zolotvok/Rp-2350-cam-module/hardware/proto1/fabrication/bom.csv

Reference | Qty | Value | DNP | Exclude from BOM | Exclude from Board | Footprint | Datasheet | LCSC
C26,C27 | 2 | 20p |  |  |  | Capacitor_SMD:C_0603_1608Metric |  | C1648
C5,C6,C8,C14,C17,C21,C22,C23,C24,C25,C33 | 11 | 0.1uF |  |  |  | Capacitor_SMD:C_0603_1608Metric |  | C14663
C2,C7,C9,C11,C12,C13,C16 | 7 | 1uF |  |  |  | Capacitor_SMD:C_0603_1608Metric |  | C15849
C1,C4 | 2 | 2.2uF |  |  |  | Capacitor_SMD:C_0603_1608Metric |  | C23630
C3 | 1 | 10uF |  |  |  | Capacitor_SMD:C_0805_2012Metric |  | C440198
C34,C35 | 2 | 10u |  |  |  | Capacitor_SMD:C_0805_2012Metric |  | C440198
R5 | 1 | 10 |  |  |  | Resistor_SMD:R_0805_2012Metric |  | C17415
R7,R8 | 2 | 22 ohm |  |  |  | Resistor_SMD:R_0805_2012Metric |  | C17561
R4 | 1 | 200 |  |  |  | Resistor_SMD:R_0805_2012Metric |  | C17540
R23,R26 | 2 | 1K |  |  |  | Resistor_SMD:R_0805_2012Metric |  | C17513
R10,R11,R12,R13,R14 | 5 | 2.2K |  |  |  | Resistor_SMD:R_0805_2012Metric |  | C17520
R1 | 1 | 5k1 |  |  |  | Resistor_SMD:R_0805_2012Metric |  | C27834
R3 | 1 | 5k1 |  |  |  | Resistor_SMD:R_0805_2012Metric_Pad1.20x1.40mm_HandSolder |  | C27834
R2,R6,R9,R16,R21 | 5 | 10K |  |  |  | Resistor_SMD:R_0805_2012Metric |  | C17414
C10 | 1 | 10uF_0805 |  |  |  | Capacitor_SMD:C_0805_2012Metric |  | C440198
C15 | 1 | 10uF_0805 |  |  |  | Capacitor_SMD:C_0603_1608Metric |  | C440198
Y1 | 1 | 12MHz_10pF_50ohm |  |  |  | Crystal:Crystal_SMD_3225-4Pin_3.2x2.5mm |  | C9002
D3 | 1 | 1N4148 |  |  |  | Diode_SMD:D_SOD-123 |  | C81598
U4 | 1 | 74LVC1G19 |  |  |  | Package_TO_SOT_SMD:SOT-23-6_Handsoldering | http://www.ti.com/lit/sg/scyt129e/scyt129e.pdf | C148208
U1,U7 | 2 | APS1604M-3SQRx-SN |  |  |  | Package_SO:SOIC-8_3.9x4.9mm_P1.27mm | https://www.mouser.com/datasheet/2/1127/APM_PSRAM_QSPI_APS1604M_3SQR_v2_7_PKG-1954896.pdf | C18214056
L5 | 1 | BLUE |  |  |  | LED_SMD:LED_0603_1608Metric |  | C2297
J3 | 1 | Conn_01x05_Pin | DNP |  |  | Connector_PinHeader_2.54mm:PinHeader_1x05_P2.54mm_Vertical |  | C22438173
J2 | 1 | Conn_02x09_Counter_Clockwise | DNP |  |  | Connector_IDC:IDC-Header_2x09_P2.54mm_Vertical |  | C22438186
L1 | 1 | DFE252012F-3R3M=P2 |  |  |  | Inductor_SMD:L_1210_3225Metric |  | C2046640
L3,ON0 | 2 | EMERALD GREEN |  |  |  | LED_SMD:LED_0603_1608Metric |  | C2297
DEBUG0 | 1 | JST_SH3 | DNP |  |  | Connector_PinHeader_2.54mm:PinHeader_1x03_P2.54mm_Vertical
U5 | 1 | NCP1117-3.3_SOT223 |  |  |  | Package_TO_SOT_SMD:SOT-223-3_TabPin2 | http://www.onsemi.com/pub_link/Collateral/NCP1117-D.PDF | C6186
L0,L2 | 2 | RED |  |  |  | LED_SMD:LED_0603_1608Metric |  | C84256
X4 | 1 | RP2350B |  |  |  | Package_DFN_QFN:QFN-80-1EP_10x10mm_P0.4mm_EP3.4x3.4mm |  | C42415655
TP1 | 1 | TESTPOINTROUND1.5MMNO | DNP |  |  | TestPoint:TestPoint_Pad_D1.0mm
S1,S2 | 2 | TS-1088-AR02016 |  |  |  | lib_foot:SW_TS-1088-AR02016
J1 | 1 | USB_C_Receptacle_USB2.0_14P |  |  |  | Connector_USB:USB_C_Receptacle_XKB_U262-16XN-4BVC11 | https://www.usb.org/sites/default/files/documents/usb_type-c.zip | C2765186
U2 | 1 | W25Q128JVS |  |  |  | Package_SO:SOIC-8_5.3x5.3mm_P1.27mm | https://www.winbond.com/resource-files/w25q128jv_dtr%20revc%2003272018%20plus.pdf | C97521
L4 | 1 | YELLOW |  |  |  | LED_SMD:LED_0603_1608Metric |  | C34499
