zolotvok/Rp-2350-cam-module/hardware/proto2/docs/schematic.pdf

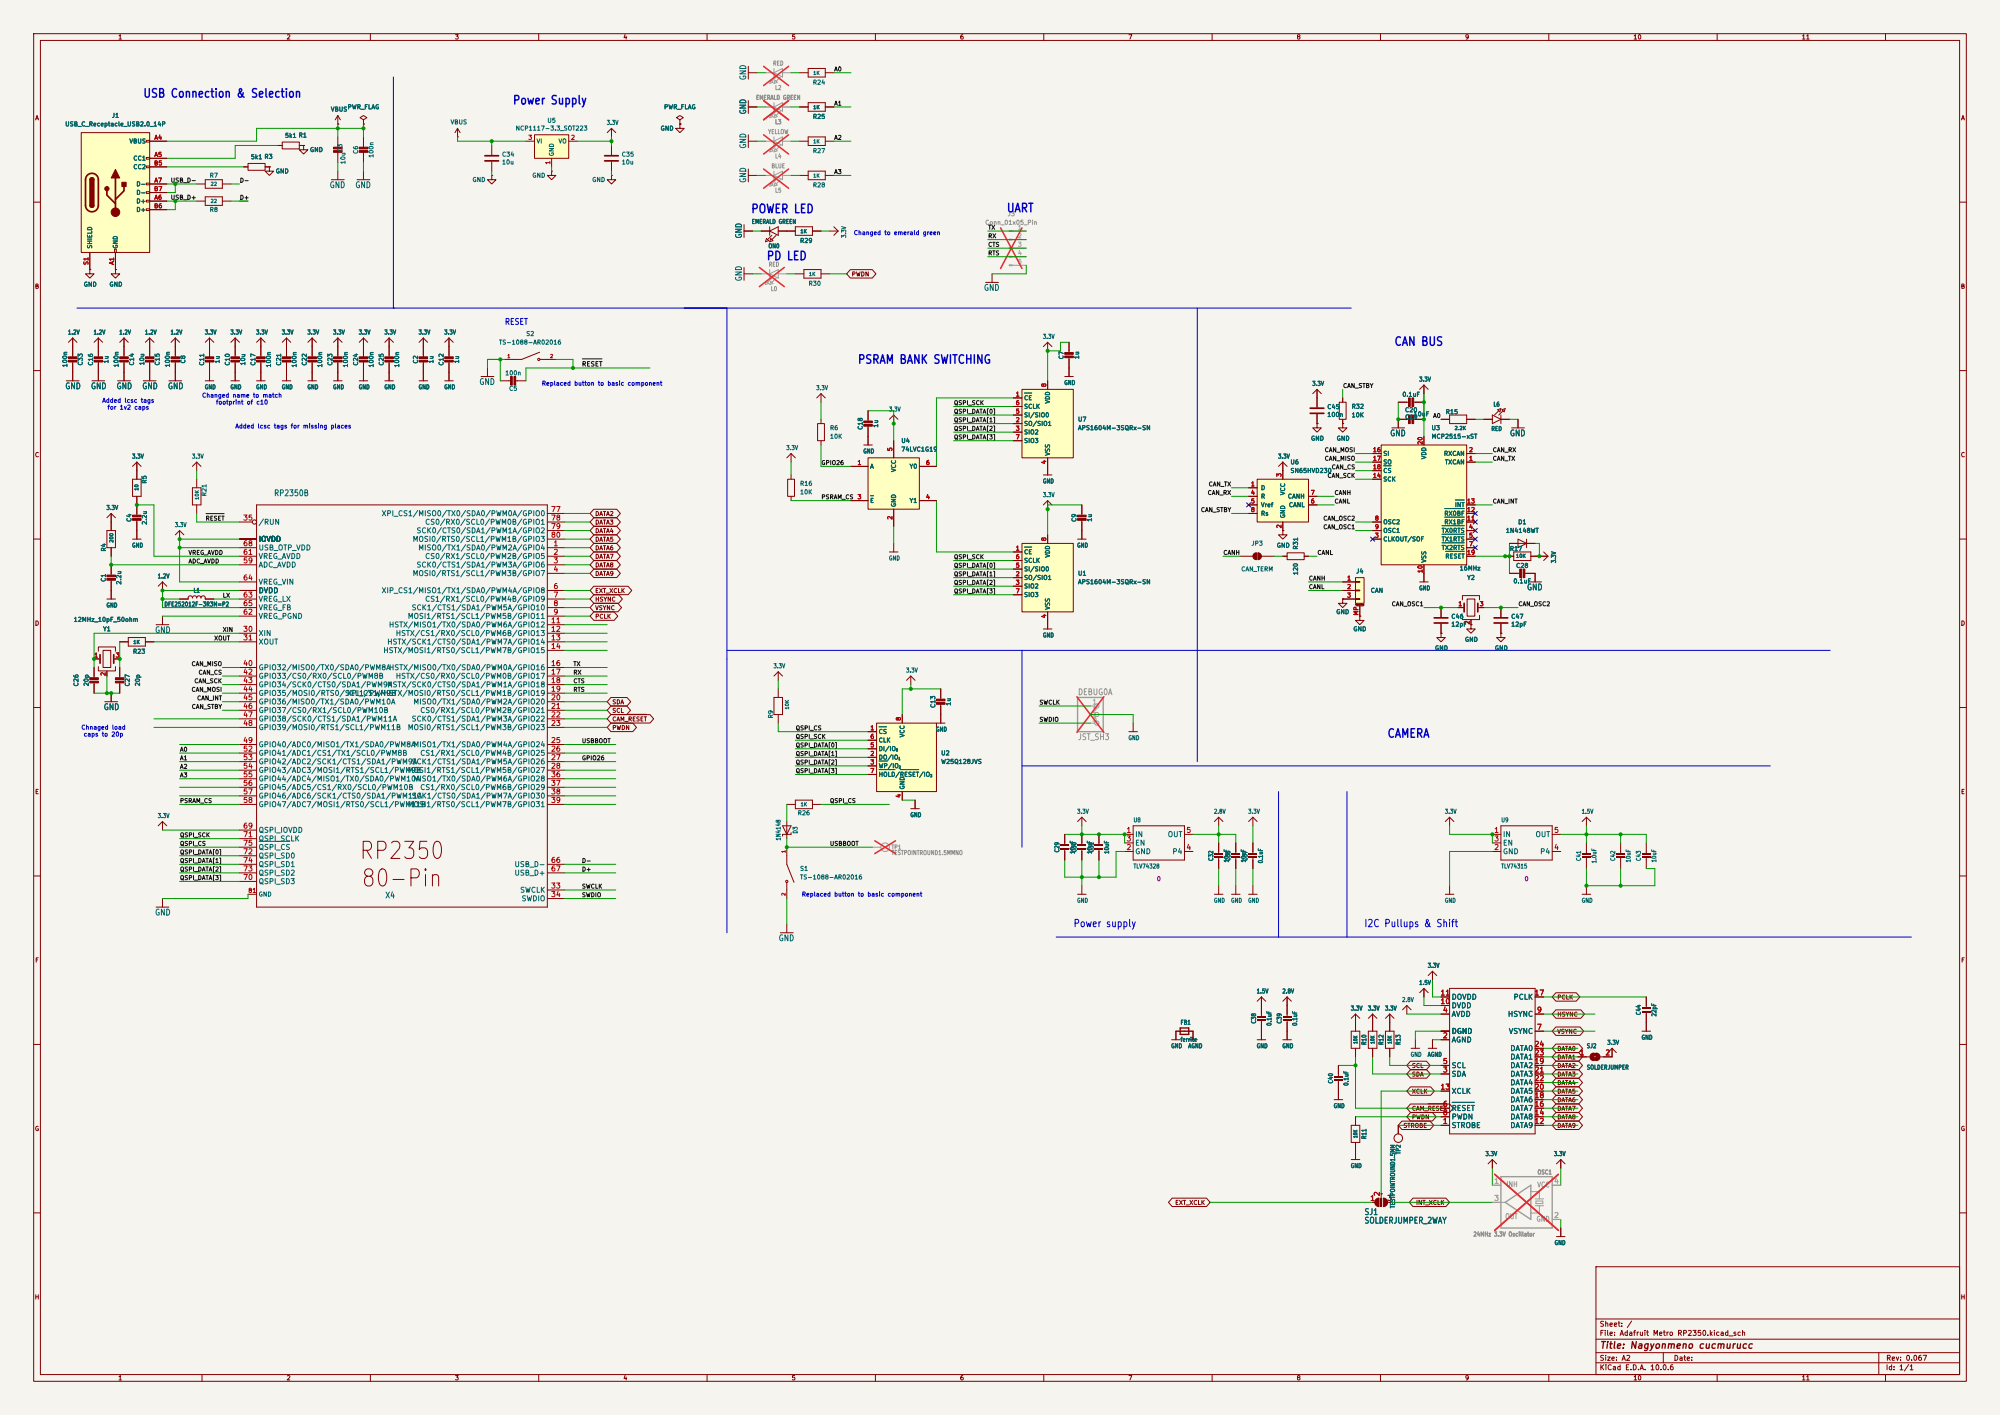
[picture p5: page 1]

Changed to emerald green PSRAM BANK SWITCHING GND

for 1v2 caps Chnaged load

Replaced button to basic component

Changed name to match

Added lcsc tags for missing places

4 DI/IO0 5 CLK 6 HOLD/RESET/IO3 7 VCC

Size: A2 | Rev: 0.067
KiCad E.D.A. 10.0.6 | Id: 1/1
