zolotvok/Rp-2350-cam-module/hardware/proto2/kicad/Adafruit Metro RP2350.kicad_pcb

## KiCad design hardware/proto2/kicad/Adafruit Metro RP2350.kicad_pcb (2026-10-27)

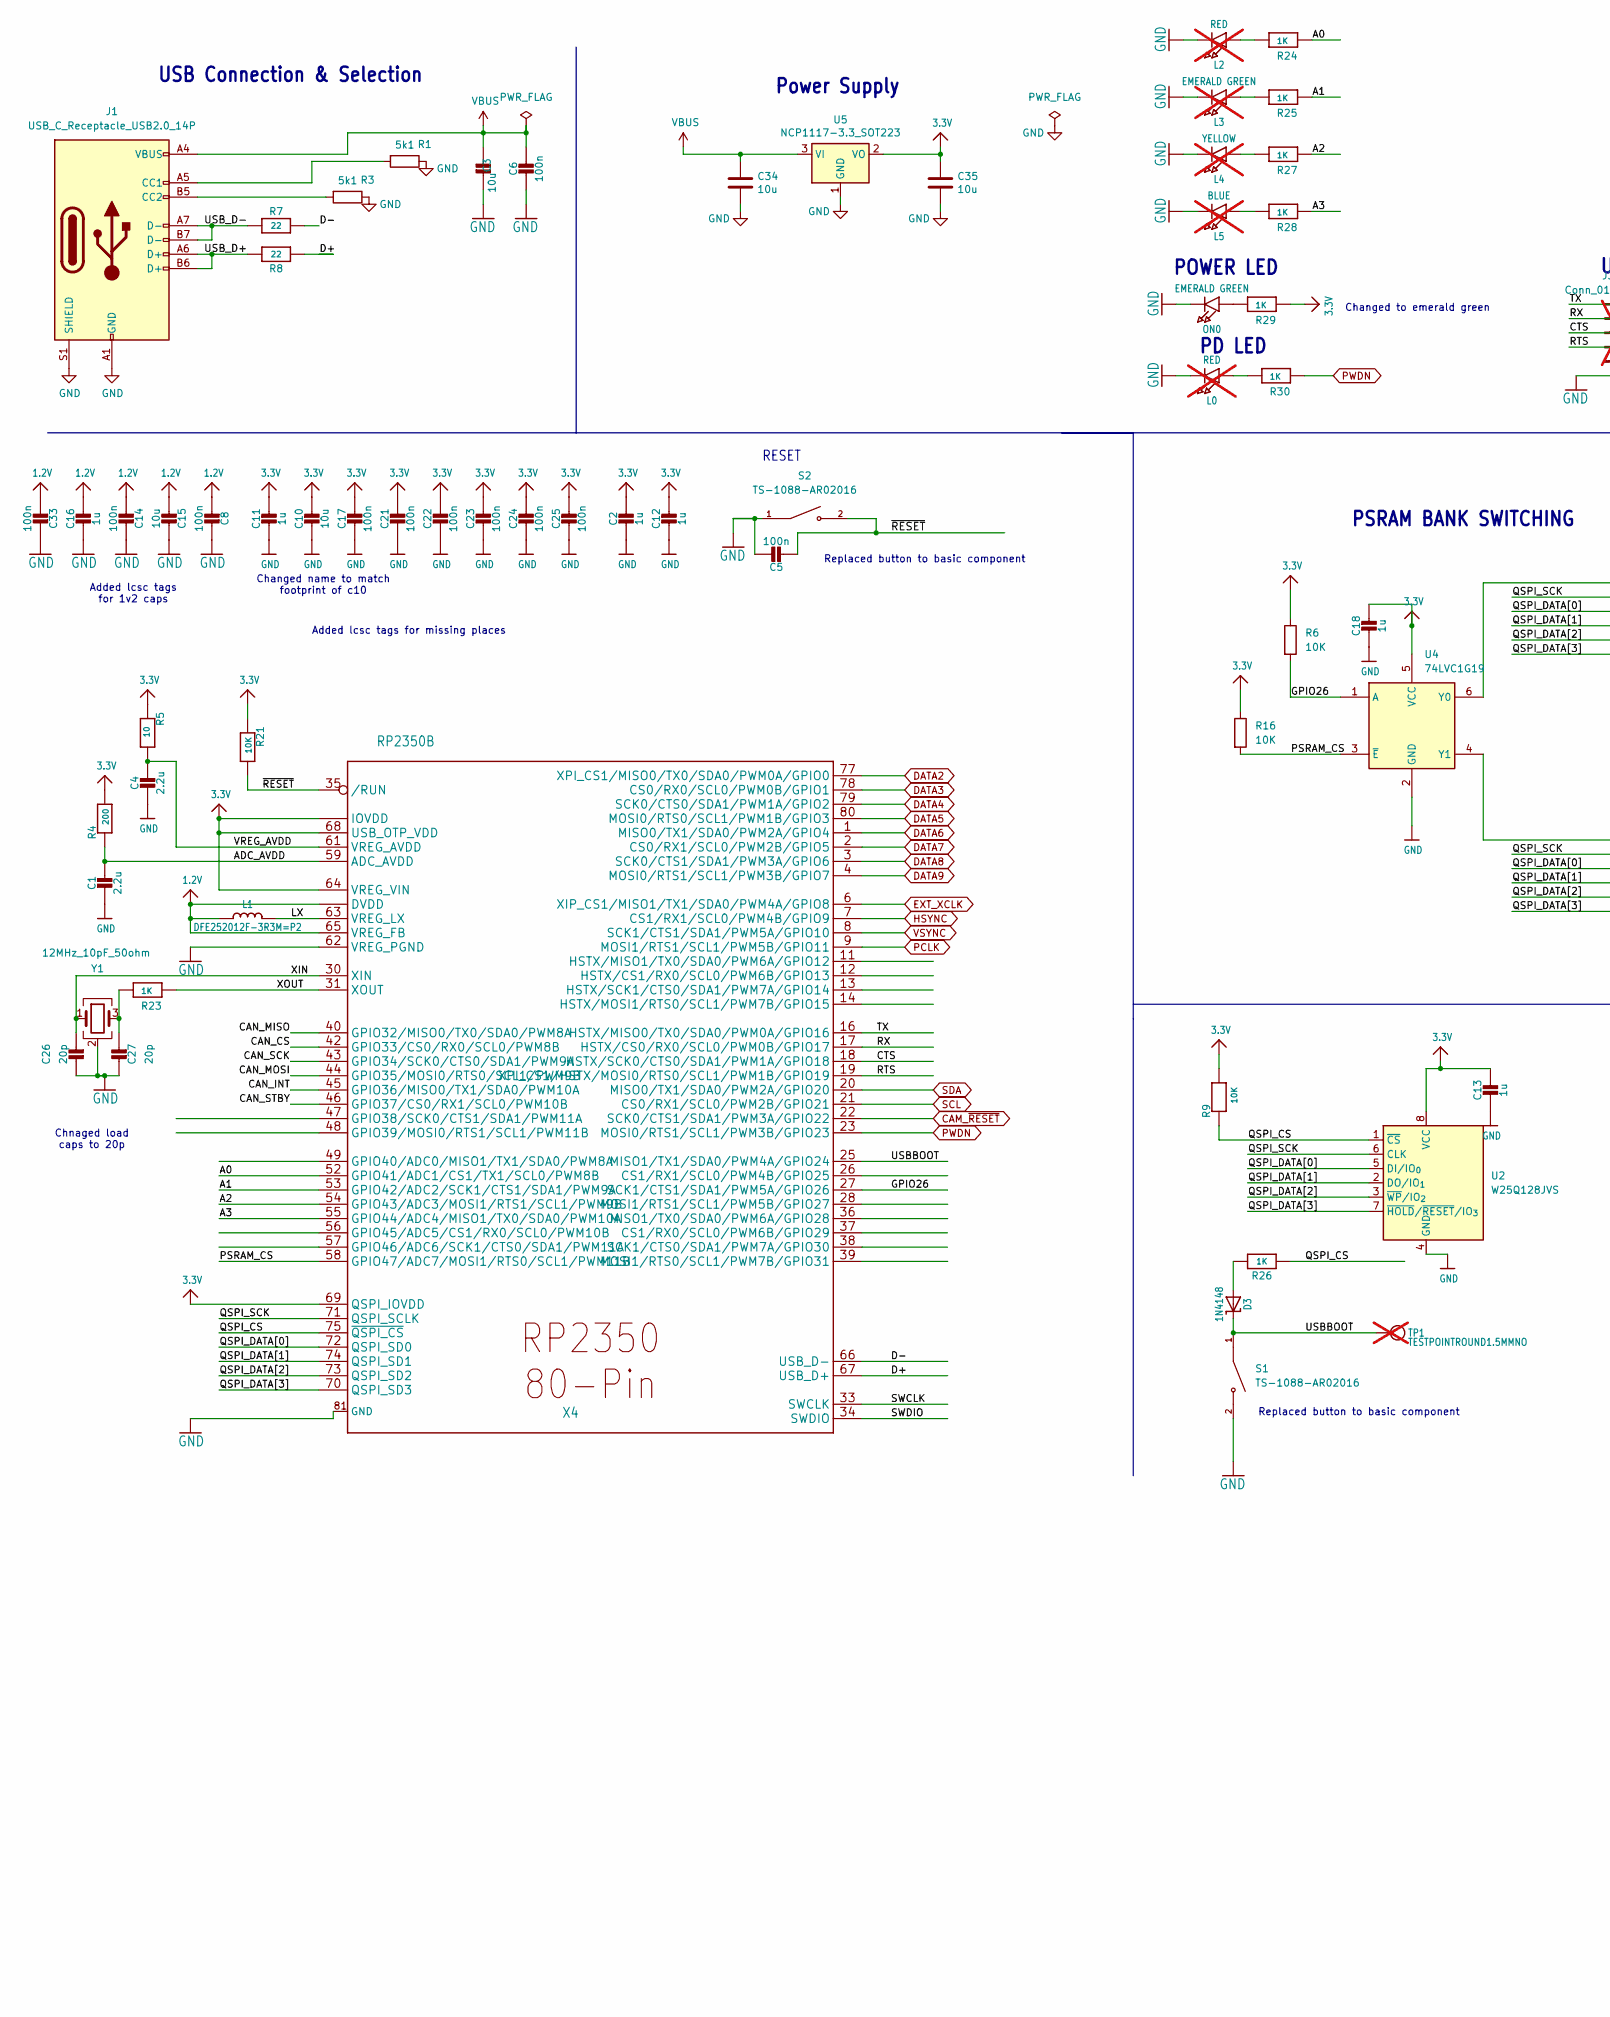
[picture p6: schematic Adafruit Metro RP2350.kicad_sch, Nagyonmeno cucmurucc, part in row 1, column 1]

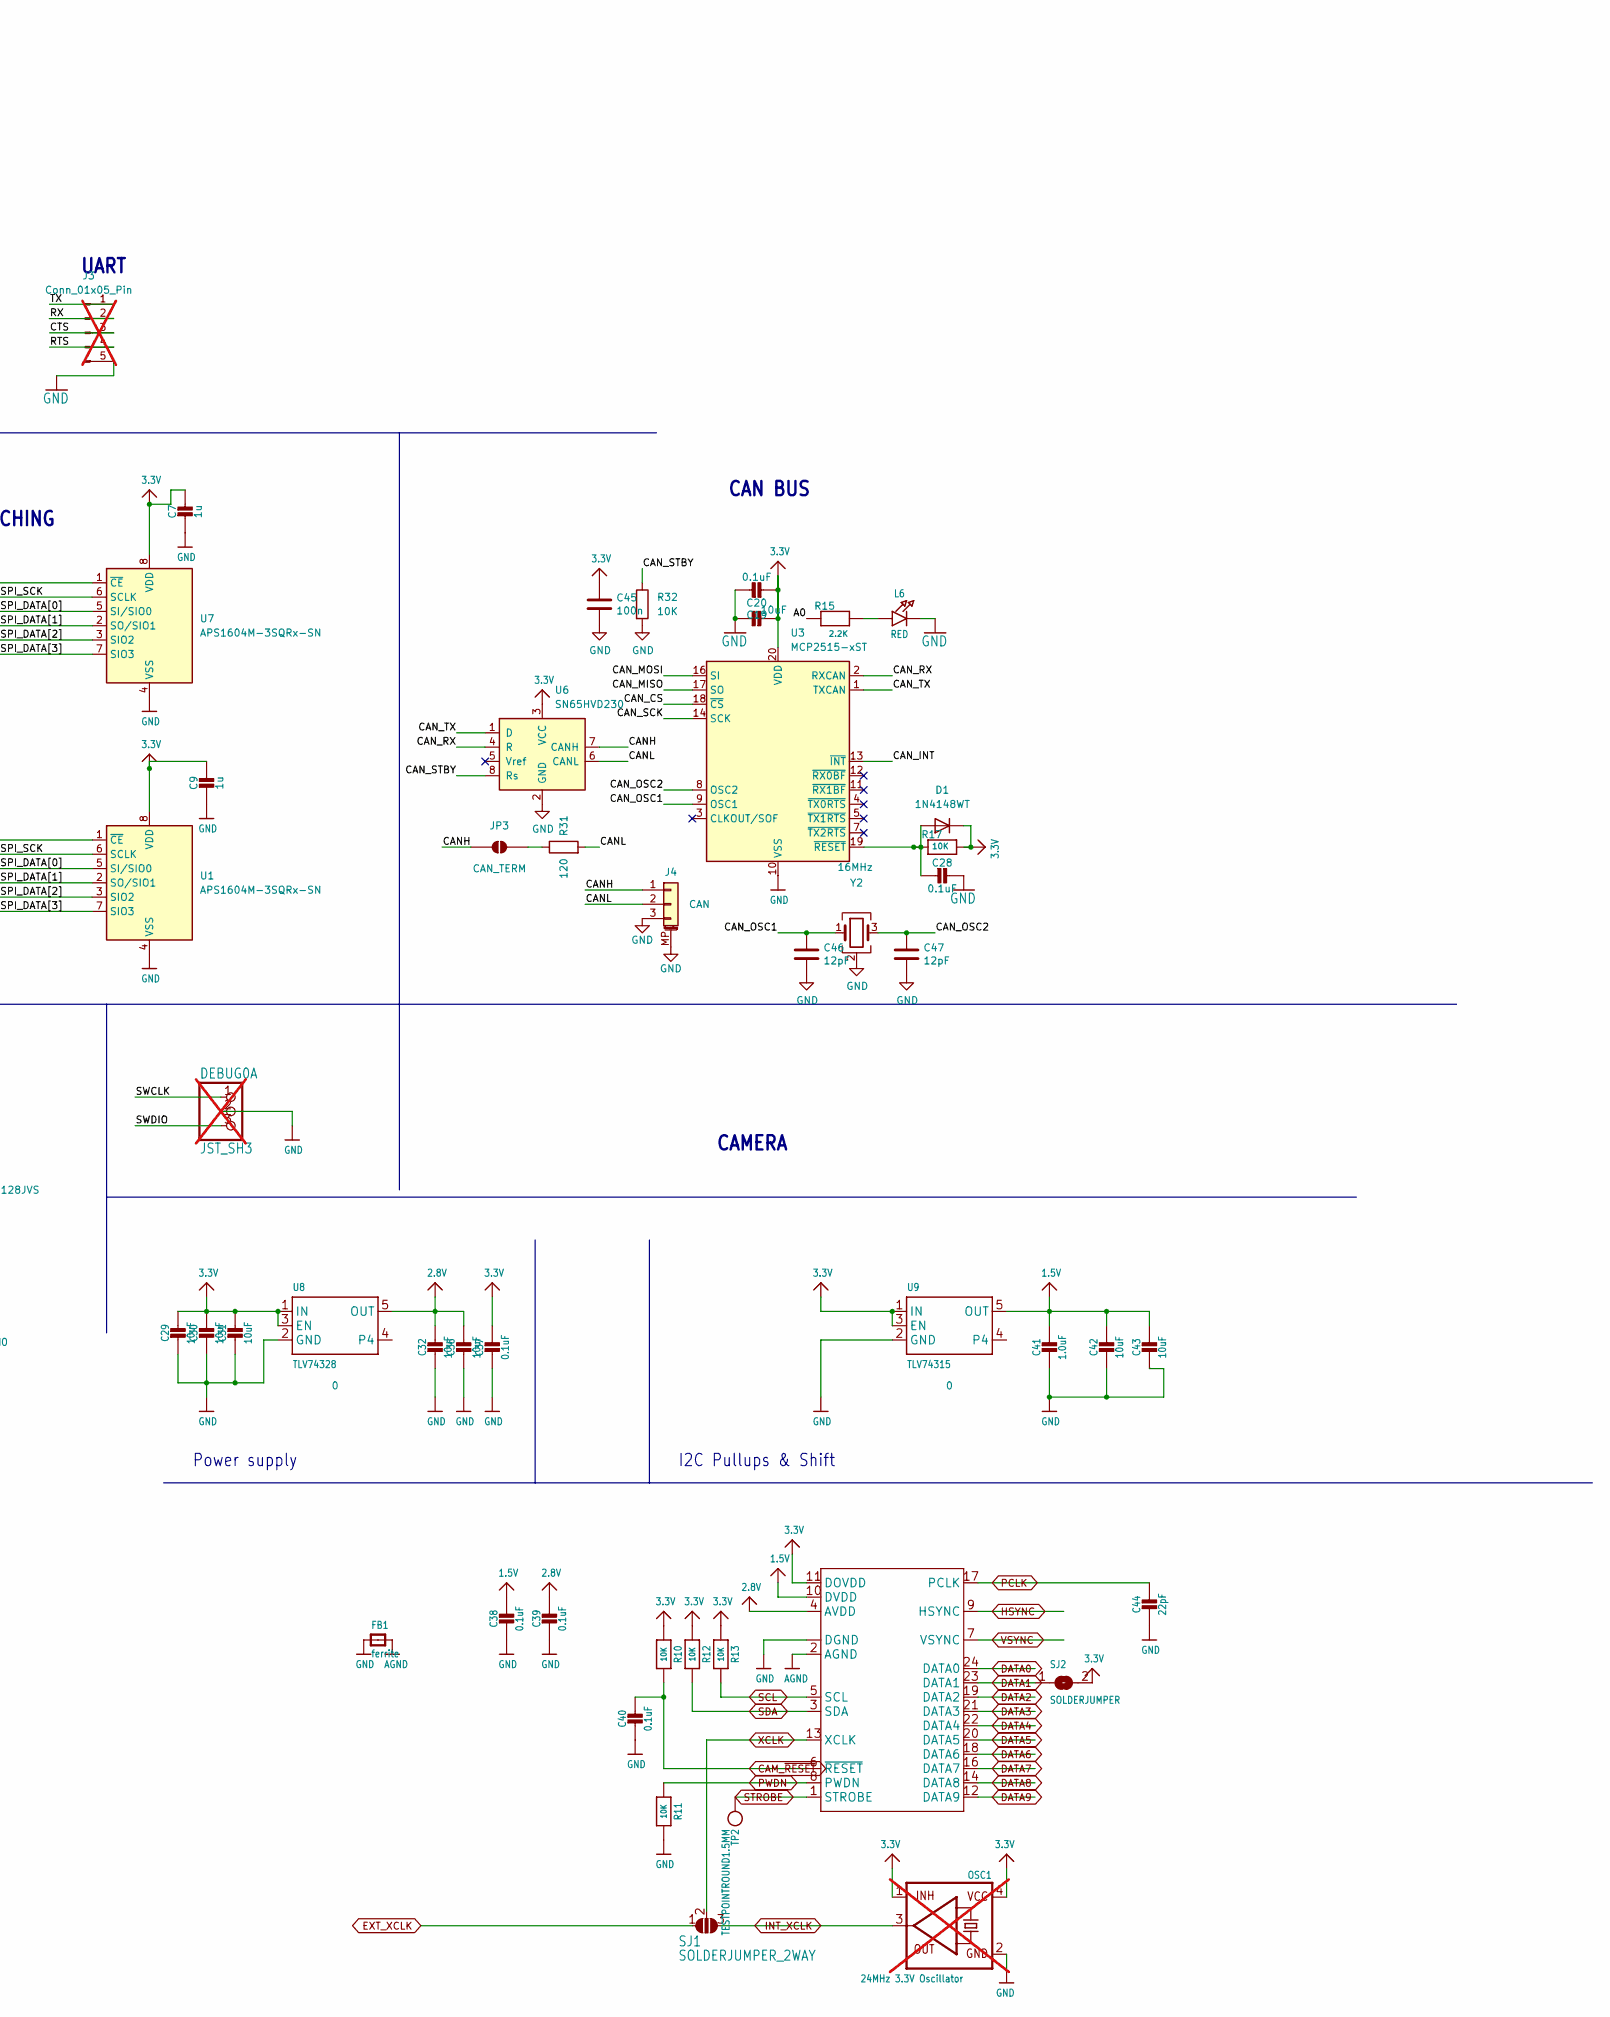
[picture p7: schematic Adafruit Metro RP2350.kicad_sch, Nagyonmeno cucmurucc, part in row 1, column 2]

Parts:
C1, C4: 2.2u; C_0402_1005Metric; LCSC C12530
C2, C7, C9, C11, C12, C13, C16, C18: 1u; C_0402_1005Metric; LCSC C52923
C3, C10, C15, C34, C35: 10u; C_0603_1608Metric; LCSC C96446
C5, C6, C8, C14, C17, C21, C22, C23, C24, C25, C33, C45: 100n; C_0402_1005Metric; LCSC C1525
C19, C29, C30, C31, C32, C36, C42, C43: 10uF; C_0603_1608Metric; LCSC C96446
C20, C28, C37, C38, C39, C40: 0.1uF; C_0402_1005Metric; LCSC C1525
C26, C27: 20p; C_0402_1005Metric; LCSC C1554
C41: 1.0uF; C_0402_1005Metric; LCSC C52923
C44: 22pF; C_0402_1005Metric; LCSC C1555
C46, C47: 12pF; C_0402_1005Metric; LCSC C1547
D1: 1N4148WT; D_SOD-523; LCSC C7420320
D3: 1N4148; D_SOD-523; LCSC C7420320
DEBUG0: JST_SH3; PinHeader_1x03_P2.54mm_Vertical; not fitted
FB1: ferrite; L_0402_1005Metric; LCSC C76886
J1: USB_C_Receptacle_USB2.0_14P; USB_C_Receptacle_XKB_U262-16XN-4BVC11; LCSC C2765186
J3: Conn_01x05_Pin; PinHeader_1x05_P2.54mm_Vertical; LCSC C22438173; not fitted
J4: CAN; JST_SH_SM03B-SRSS-TB_1x03-1MP_P1.00mm_Horizontal; LCSC C7430445
JP3: CAN_TERM; SolderJumper-2_P1.3mm_Open_RoundedPad1.0x1.5mm
L0, L2: RED; LED_0402_1005Metric; LCSC C25503345; not fitted
L1: DFE252012F-3R3M=P2; L_1210_3225Metric; LCSC C2046640
L3: EMERALD GREEN; LED_0402_1005Metric; LCSC C965793; not fitted
L4: YELLOW; LED_0402_1005Metric; LCSC C25503856; not fitted
L5: BLUE; LED_0402_1005Metric; LCSC C22355736; not fitted
L6: RED; LED_0402_1005Metric; LCSC C25503345
ON0: EMERALD GREEN; LED_0402_1005Metric; LCSC C965793
OSC1: 24MHz 3.3V Oscillator; Oscillator_SMD_Abracon_ASE-4Pin_3.2x2.5mm; LCSC C712738; not fitted
R1, R3: 5k1; R_0402_1005Metric; LCSC C25905
R4: 200; R_0402_1005Metric; LCSC C25087
R5: 10; R_0402_1005Metric; LCSC C25077
R6, R9, R10, R11, R12, R13, R16, R17, R21, R32: 10K; R_0402_1005Metric; LCSC C25744
R7, R8: 22; R_0402_1005Metric; LCSC C25092
R15: 2.2K; R_0402_1005Metric; LCSC C25879
R23, R24, R25, R26, R27, R28, R29, R30: 1K; R_0402_1005Metric; LCSC C11702
R31: 120; R_0402_1005Metric; LCSC C25079
S1, S2: TS-1088-AR02016; SW_SPST_TS-1088-xR020; PARTREV N/A; LCSC C720477
SJ1: SOLDERJUMPER_2WAY; SolderJumper-3_P1.3mm_Bridged12_RoundedPad1.0x1.5mm_NumberL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
SJ2: SOLDERJUMPER; SolderJumper-2_P1.3mm_Open_RoundedPad1.0x1.5mm
TP1: TESTPOINTROUND1.5MMNO; TestPoint_Pad_D1.0mm; not fitted
TP2: TESTPOINTROUND1.5MM; TestPoint_Pad_D1.5mm
U1, U7: APS1604M-3SQRx-SN; SOIC-8_3.9x4.9mm_P1.27mm; LCSC C18214056
U2: W25Q128JVS; SOIC-8_5.3x5.3mm_P1.27mm; LCSC C97521
U3: MCP2515-xST; TSSOP-20_4.4x6.5mm_P0.65mm; LCSC C609745
U4: 74LVC1G19; SOT-363_SC-70-6; LCSC C148208
U5: NCP1117-3.3_SOT223; SOT-223-3_TabPin2; LCSC C6186
U6: SN65HVD230; SOIC-8_3.9x4.9mm_P1.27mm; LCSC C16468
U8: TLV74328; SOT-23-5; JLC_ROTATION 270
U9: TLV74315; SOT-23-5; JLC_ROTATION 270
X1: CAMERA_OV2640; Jushuo_AFC07-S24FCA-00_1x24-1MP_P0.50_Horizontal; LCSC C262567
X4: RP2350B; QFN-80-1EP_10x10mm_P0.4mm_EP3.4x3.4mm; LCSC C42415655
Y1: 12MHz_10pF_50ohm; Crystal_SMD_3225-4Pin_3.2x2.5mm; LCSC C9002
Y2: 16MHz; Crystal_SMD_3225-4Pin_3.2x2.5mm; LCSC C13738

Connections:
1.2V: C8.2, C14.2, C15.2, C16.1, C33.2, L1.1, X4.10 (DVDD), X4.32 (DVDD), X4.51 (DVDD), X4.65 (VREG_FB)
1.5V: C38.1, C41.1, C42.1, C43.1, U9.5 (OUT), X1.10 (DVDD)
2.8V: C32.1, C36.1, C39.1, U8.5 (OUT), X1.4 (AVDD)
3.3V: C2.1, C7.1, C9.1, C10.1, C11.1, C12.1, C13.1, C17.1, C18.1, C19.1, C20.2, C21.1, C22.1, C23.1, C24.1, C25.1, C29.1, C30.1, C31.1, C35.1, C37.1, C45.1, D1.1 (K), OSC1.1 (INH), OSC1.4 (VCC), R4.2, R5.1, R6.1, R9.2, R10.1, R12.1, R13.1, R16.1, R17.2, R21.1, R29.2, SJ2.2, U1.8 (VDD), U2.8 (VCC), U3.20 (VDD), U4.5 (VCC), U5.2 (VO), U6.3 (VCC), U7.8 (VDD), U8.1 (IN), U8.3 (EN), U9.1 (IN), U9.3 (EN), X1.11 (DOVDD), X4.5 (IOVDD), X4.15 (IOVDD), X4.24 (IOVDD), X4.29 (IOVDD), X4.41 (IOVDD), X4.50 (IOVDD), X4.60 (IOVDD), X4.64 (VREG_VIN), X4.68 (USB_OTP_VDD), X4.69 (QSPI_IOVDD), X4.76 (IOVDD)
/A0: R15.1, R24.2, X4.52 (GPIO41/ADC1/CS1/TX1/SCL0/PWM8B)
/A1: R25.2, X4.53 (GPIO42/ADC2/SCK1/CTS1/SDA1/PWM9A)
/A2: R27.2, X4.54 (GPIO43/ADC3/MOSI1/RTS1/SCL1/PWM9B)
/A3: R28.2, X4.55 (GPIO44/ADC4/MISO1/TX0/SDA0/PWM10A)
/ADC_AVDD: C1.1, R4.1, X4.59 (ADC_AVDD)
/CANH: J4.1, JP3.1 (A), U6.7 (CANH)
/CANL: J4.2, R31.2, U6.6 (CANL)
/CAN_CS: U3.18 (~CS), X4.42 (GPIO33/CS0/RX0/SCL0/PWM8B)
/CAN_INT: U3.13 (~INT), X4.45 (GPIO36/MISO0/TX1/SDA0/PWM10A)
/CAN_MISO: U3.17 (SO), X4.40 (GPIO32/MISO0/TX0/SDA0/PWM8A)
/CAN_MOSI: U3.16 (SI), X4.44 (GPIO35/MOSI0/RTS0/SCL1/PWM9B)
/CAN_OSC1: C46.1, U3.9 (OSC1), Y2.1
/CAN_OSC2: C47.1, U3.8 (OSC2), Y2.3
/CAN_RX: U3.2 (RXCAN), U6.4 (R)
/CAN_SCK: U3.14 (SCK), X4.43 (GPIO34/SCK0/CTS0/SDA1/PWM9A)
/CAN_STBY: R32.1, U6.8 (Rs), X4.46 (GPIO37/CS0/RX1/SCL0/PWM10B)
/CAN_TX: U3.1 (TXCAN), U6.1 (D)
/CTS: J3.3, X4.18 (HSTX/SCK0/CTS0/SDA1/PWM1A/GPIO18)
/D+: R8.2, X4.67 (USB_D+)
/D-: R7.2, X4.66 (USB_D-)
/GPIO26: R6.2, U4.1 (A), X4.27 (SCK1/CTS1/SDA1/PWM5A/GPIO26)
/LX: L1.2, X4.63 (VREG_LX)
/PSRAM_CS: R16.2, U4.3 (~E), X4.58 (GPIO47/ADC7/MOSI1/RTS0/SCL1/PWM11B)
/QSPI_CS: R9.1, R26.1, U2.1 (~CS), X4.75 (~QSPI_CS)
/QSPI_DATA[0]: U1.5 (SI/SIO0), U2.5 (DI/IO_{0}), U7.5 (SI/SIO0), X4.72 (QSPI_SD0)
/QSPI_DATA[1]: U1.2 (SO/SIO1), U2.2 (DO/IO_{1}), U7.2 (SO/SIO1), X4.74 (QSPI_SD1)
/QSPI_DATA[2]: U1.3 (SIO2), U2.3 (~WP/IO_{2}), U7.3 (SIO2), X4.73 (QSPI_SD2)
/QSPI_DATA[3]: U1.7 (SIO3), U2.7 (~HOLD/~RESET/IO_{3}), U7.7 (SIO3), X4.70 (QSPI_SD3)
/QSPI_SCK: U1.6 (SCLK), U2.6 (CLK), U7.6 (SCLK), X4.71 (QSPI_SCLK)
/RTS: J3.4, X4.19 (XPI_CS1/HSTX/MOSI0/RTS0/SCL1/PWM1B/GPIO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)
/RX: J3.2, X4.17 (HSTX/CS0/RX0/SCL0/PWM0B/GPIO17)
/SWCLK: DEBUG0.1, X4.33 (SWCLK)
/SWDIO: DEBUG0.3, X4.34 (SWDIO)
/TX: J3.1, X4.16 (HSTX/MISO0/TX0/SDA0/PWM0A/GPIO16)
/USBBOOT: D3.1 (C), S1.1, TP1.1 (P$1_1), X4.25 (MISO1/TX1/SDA0/PWM4A/GPIO24)
/USB_D+: J1.A6 (D+), J1.B6 (D+), R8.1
/USB_D-: J1.A7 (D-), J1.B7 (D-), R7.1
/VREG_AVDD: C4.1, R5.2, X4.61 (VREG_AVDD)
/XIN: C26.2, X4.30 (XIN), Y1.1
/XOUT: R23.2, X4.31 (XOUT)
/~RESET: C5.2, R21.2, S2.2, X4.35 (/RUN)
AGND: FB1.2, X1.2 (AGND)
CAM_~RESET: C40.1, R10.2, X1.6 (~RESET), X4.22 (SCK0/CTS1/SDA1/PWM3A/GPIO22)
DATA0: X1.24 (DATA0)
DATA1: SJ2.1, X1.23 (DATA1)
DATA2: X1.19 (DATA2), X4.77 (XPI_CS1/MISO0/TX0/SDA0/PWM0A/GPIO0)
DATA3: X1.21 (DATA3), X4.78 (CS0/RX0/SCL0/PWM0B/GPIO1)
DATA4: X1.22 (DATA4), X4.79 (SCK0/CTS0/SDA1/PWM1A/GPIO2)
DATA5: X1.20 (DATA5), X4.80 (MOSI0/RTS0/SCL1/PWM1B/GPIO3)
DATA6: X1.18 (DATA6), X4.1 (MISO0/TX1/SDA0/PWM2A/GPIO4)
DATA7: X1.16 (DATA7), X4.2 (CS0/RX1/SCL0/PWM2B/GPIO5)
DATA8: X1.14 (DATA8), X4.3 (SCK0/CTS1/SDA1/PWM3A/GPIO6)
DATA9: X1.12 (DATA9), X4.4 (MOSI0/RTS1/SCL1/PWM3B/GPIO7)
EXT_XCLK: SJ1.1, X4.6 (XIP_CS1/MISO1/TX1/SDA0/PWM4A/GPIO8)
GND: C1.2, C2.2, C3.1, C4.2, C5.1, C6.2, C7.2, C8.1, C9.2, C10.2, C11.2, C12.2, C13.2, C14.1, C15.1, C16.2, C17.2, C18.2, C19.2, C20.1, C21.2, C22.2, C23.2, C24.2, C25.2, C26.1, C27.1, C28.1, C29.2, C30.2, C31.2, C32.2, C33.1, C34.2, C35.2, C36.2, C37.2, C38.2, C39.2, C40.2, C41.2, C42.2, C43.2, C44.2, C45.2, C46.2, C47.2, DEBUG0.2, FB1.1, J1.A1 (GND), J1.A12 (GND), J1.B1 (GND), J1.B12 (GND), J1.S1 (SHIELD), J3.5, J4.3, J4.MP (MountPin), L0.1 (C), L2.1 (C), L3.1 (C), L4.1 (C), L5.1 (C), L6.1 (C), ON0.1 (C), OSC1.2 (GND), R1.1, R3.1, R11.2, R32.2, S1.2, S2.1, U1.4 (VSS), U2.4 (GND), U3.10 (VSS), U4.2 (GND), U5.1 (GND), U6.2 (GND), U7.4 (VSS), U8.2 (GND), U9.2 (GND), X1.15 (DGND), X1.MP (DGND), X4.62 (VREG_PGND), X4.81 (GND), Y1.2 (G), Y1.4 (G), Y2.2 (G), Y2.4 (G)
HSYNC: X1.9 (HSYNC), X4.7 (CS1/RX1/SCL0/PWM4B/GPIO9)
INT_XCLK: OSC1.3 (OUT), SJ1.3
unnamed: C27.2, R23.1, Y1.3
unnamed: C28.2, D1.2 (A), R17.1, U3.19 (~RESET)
unnamed: D3.2 (A), R26.2
unnamed: J1.A5 (CC1), R1.2
unnamed: J1.B5 (CC2), R3.2
unnamed: JP3.2 (B), R31.1
unnamed: L0.2 (A), R30.1
unnamed: L2.2 (A), R24.1
unnamed: L3.2 (A), R25.1
unnamed: L4.2 (A), R27.1
unnamed: L5.2 (A), R28.1
unnamed: L6.2 (A), R15.2
unnamed: ON0.2 (A), R29.1
unnamed: U1.1 (~CE), U4.4 (Y1)
unnamed: U4.6 (Y0), U7.1 (~CE)
PCLK: C44.1, X1.17 (PCLK), X4.9 (MOSI1/RTS1/SCL1/PWM5B/GPIO11)
PWDN: R11.1, R30.2, X1.8 (PWDN), X4.23 (MOSI0/RTS1/SCL1/PWM3B/GPIO23)
SCL: R13.2, X1.5 (SCL), X4.21 (CS0/RX1/SCL0/PWM2B/GPIO21)
SDA: R12.2, X1.3 (SDA), X4.20 (MISO0/TX1/SDA0/PWM2A/GPIO20)
STROBE: TP2.1 (P$1_1), X1.1 (STROBE)
VBUS: C3.2, C6.1, C34.1, J1.A4 (VBUS), J1.A9 (VBUS), J1.B4 (VBUS), J1.B9 (VBUS), U5.3 (VI)
VSYNC: X1.7 (VSYNC), X4.8 (SCK1/CTS1/SDA1/PWM5A/GPIO10)
XCLK: SJ1.2, X1.13 (XCLK)

Notes on the sheet:
Changed name to match footprint of c10
Changed to emerald green
PSRAM BANK SWITCHING
Added lcsc tags for missing places
CAN BUS
POWER LED
Added lcsc tags for 1v2 caps
CAMERA
Power Supply
Chnaged load caps to 20p
I2C Pullups & Shift
RESET
Replaced button to basic component
UART
USB Connection & Selection
PD LED
Power supply

Board: 4 copper layers, 109 parts (61 on the bottom side), 83 nets, no tracks yet.
