zolotvok/Rp-2350-cam-module/(commit log)

2026-05-04 second commit
    [Adafruit Metro RP2350.kicad_pcb, Adafruit Metro RP2350.kicad_sch, Adafruit Metro RP2350.sch]
2026-10-26 Restructure repository and add documentation
    - Move the prototypes under hardware/: proto1 (sent to manufacturing,
    same files as the proto1 branch, plus gerbers, BOM and pick-and-place)
    and proto2 (work in progress)
    - Add READMEs for the repository and for each prototype
    - Add schematic PDF and board renders for proto1, and
    scripts/export-docs.sh to regenerate them
    - License under CC BY-SA 4.0; NOTICE.md credits the Adafruit Metro
    RP2350 and Adafruit OV5640 Camera Breakout designs (CC BY-SA 3.0)
    - Remove KiCad backups, lock and cache files and the original EAGLE
    files from version control and ignore them in .gitignore
2026-10-27 proto2: smaller footprints, direct camera wiring, CAN block, 40x40 placement
    - Passives moved to 0402 (10 uF to 0603), diodes to SOD-523, LEDs to 0402,
    with LCSC numbers for JLC basic/preferred parts where available
    - All footprints from the standard KiCad libraries; Eagle-imported LED,
    diode, inductor and test point pins renumbered to match the pads
    - Camera header pair (J2, JP1, JP2) removed and the camera wired straight
    to the RP2350B; D2-D9 now on GPIO0-7 in order; camera reset on its own
    net (GPIO22) instead of the RP2350 RUN net
    - CAN: JST SH connector (J4), jumper-selectable 120 R terminator, MCP2515
    on SPI0 (GPIO32-35), INT on GPIO36, transceiver standby on GPIO37,
    16 MHz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
2026-10-27 Update proto2 README for the current design
    Describe the changes from proto1 as done, document the RP2350B pin
    assignment, the camera clock jumper, the CAN bus, connectors, solder
    jumpers and LEDs, and the state of the 40 x 40 mm PCB.
2026-10-27 Show proto2 in the main README, add proto2 renders
    - Main README: proto2 renders instead of proto1, "proto2 at a glance"
    with the block diagram extended by the CAN bus and camera regulators
    - proto1 README now shows its own renders
    - proto2 docs/: schematic PDF and top/bottom renders of the placement
    - export-docs.sh renders proto2 square (40 x 40 mm board)
    - PCB synced with the schematic: D2, SJ3, R2 removed, ON0 populated
